ZeniteSolar/MIC19/hardware/IMG/3DDOWN.png

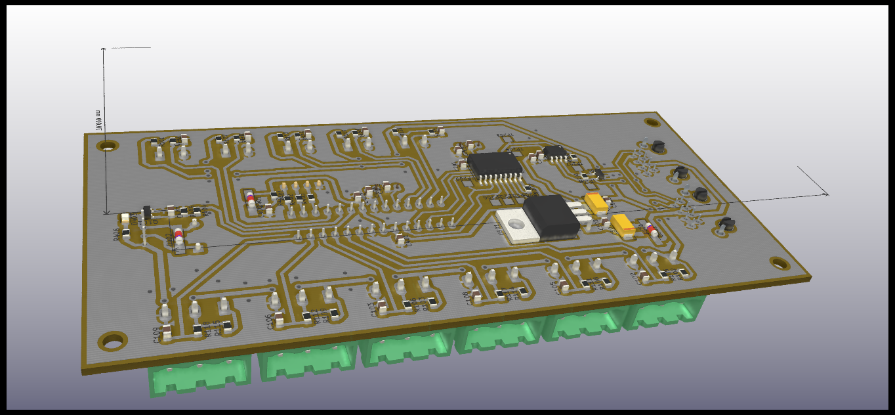
hardware/IMG/3DDOWN.png
