ZeniteSolar/MIC19/hardware/IMG/3DUP.png

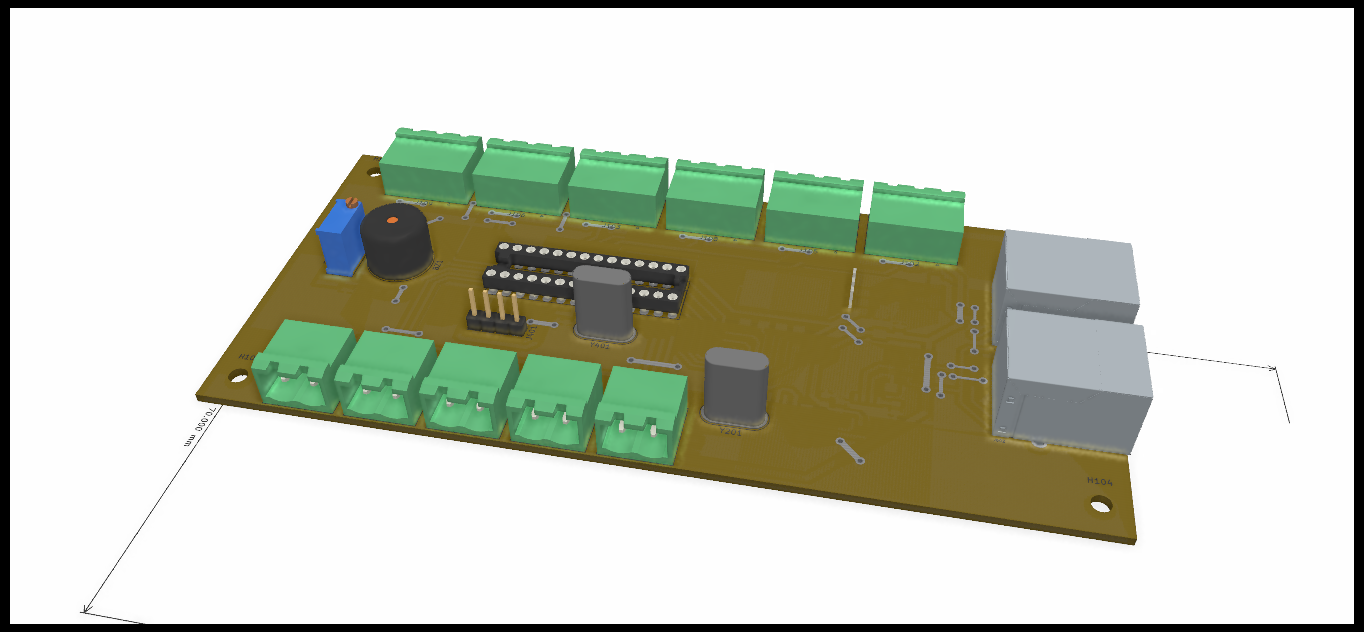
hardware/IMG/3DUP.png
