ZeniteSolar/MIC19/hardware/IMG/layout.png

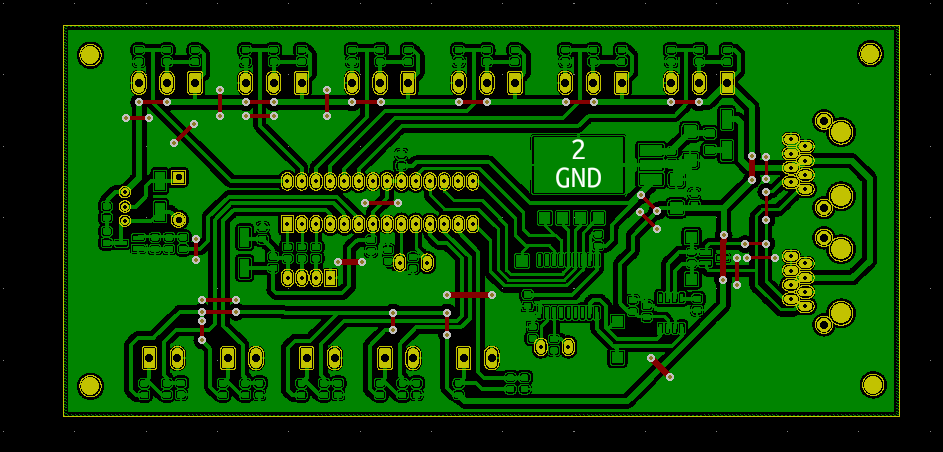
hardware/IMG/layout.png
