ZeniteSolar/MIC19/hardware/rj45.step

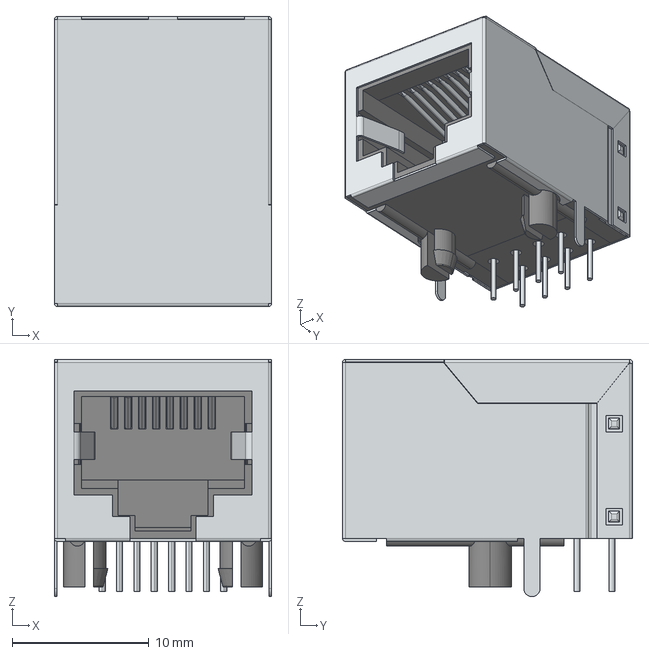
[picture p4: CAD file, 2019-04-30]
hardware/rj45.step
15.9 x 21.2 x 17.3 mm
