ZeniteSolar/MIC19/hardware/PDF/MIC19.pdf

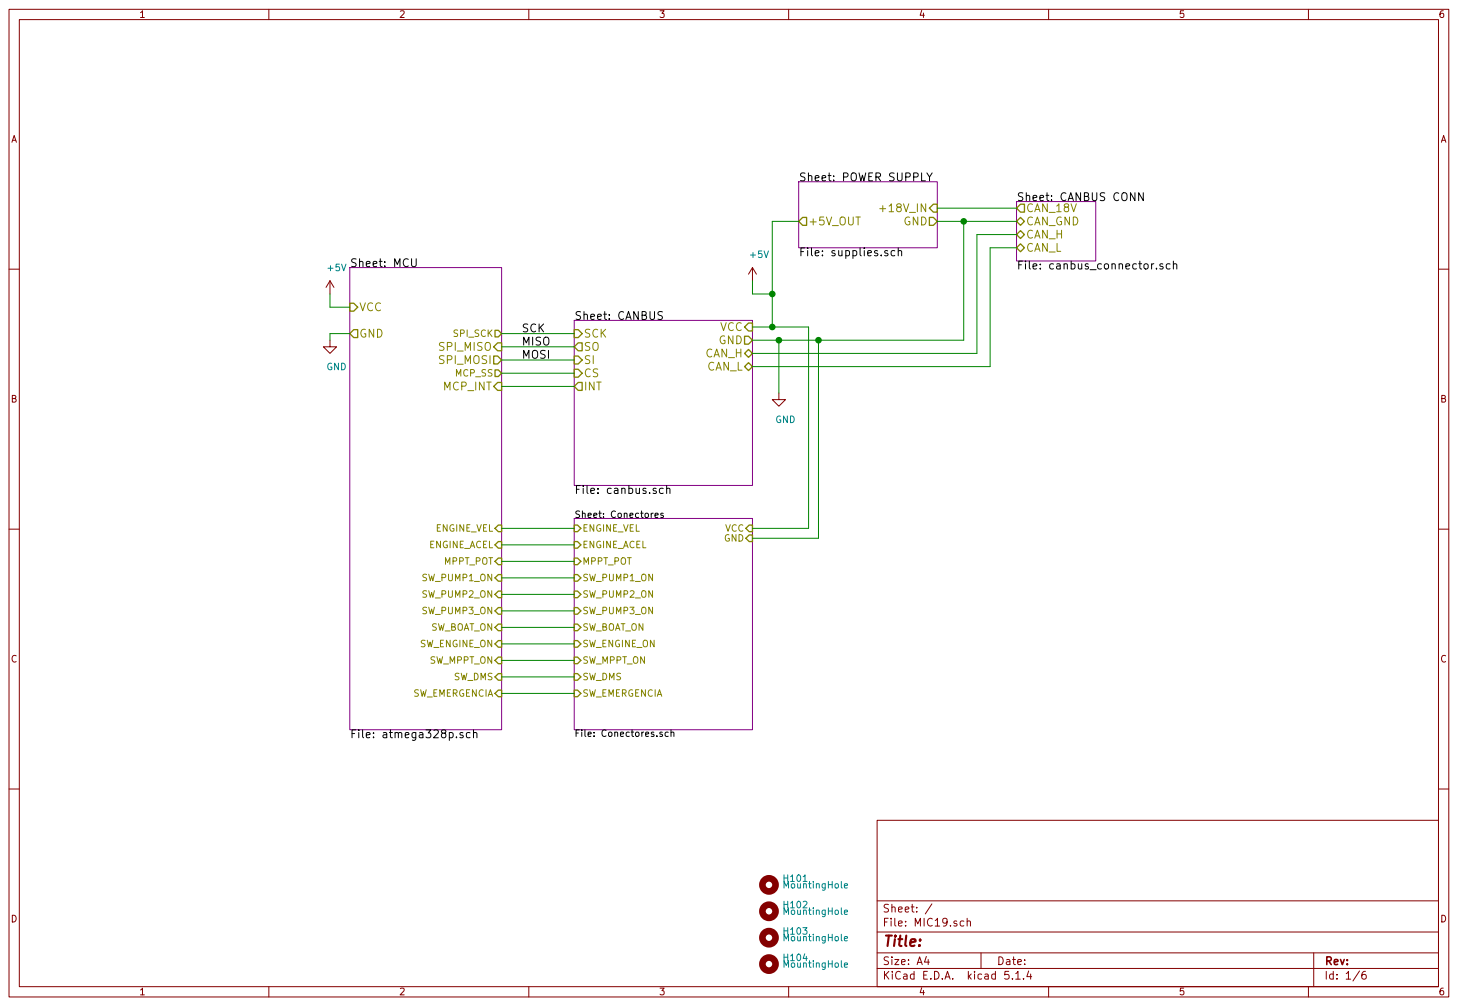
[picture p5: page 1]

Sheet: POWER SUPPLY
+5V GND
SW_EMERGENCIA Sheet: CANBUS
SCK
File: canbus.sch SI

MISO
MOSI

Id: 1/6 Title: File: MIC19.sch Sheet: /

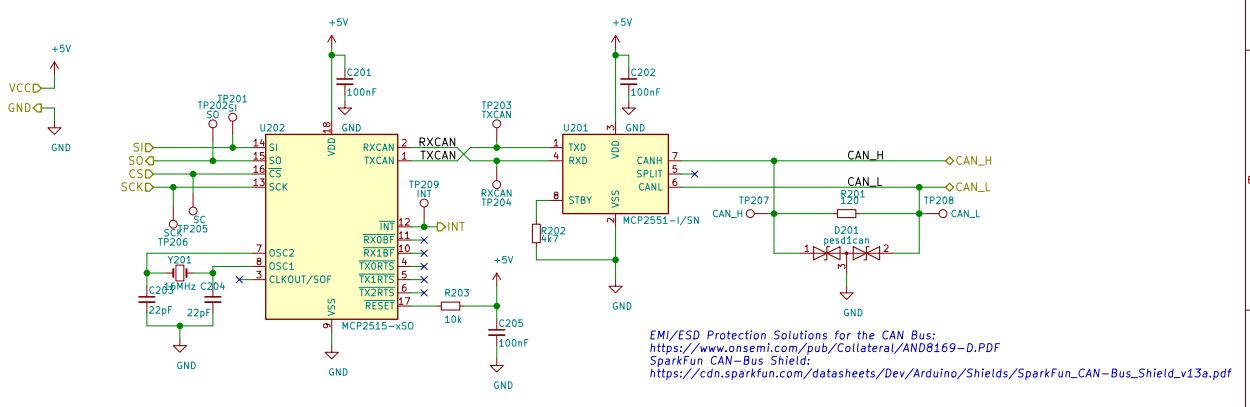
[picture p6: page 2]

3 RXD 4 SPLIT 5 CANL 6 CANH 7 STBY 8 U201 MCP2551-I/SN

EMI/ESD Protection Solutions for the CAN Bus:
https://www.onsemi.com/pub/Collateral/AND8169-D.PDF
SparkFun CAN-Bus Shield:
https://cdn.sparkfun.com/datasheets/Dev/Arduino/Shields/SparkFun_CAN-Bus_Shield_v13a.pdf

Id: 2/6 Title: File: canbus.sch Sheet: /CANBUS/

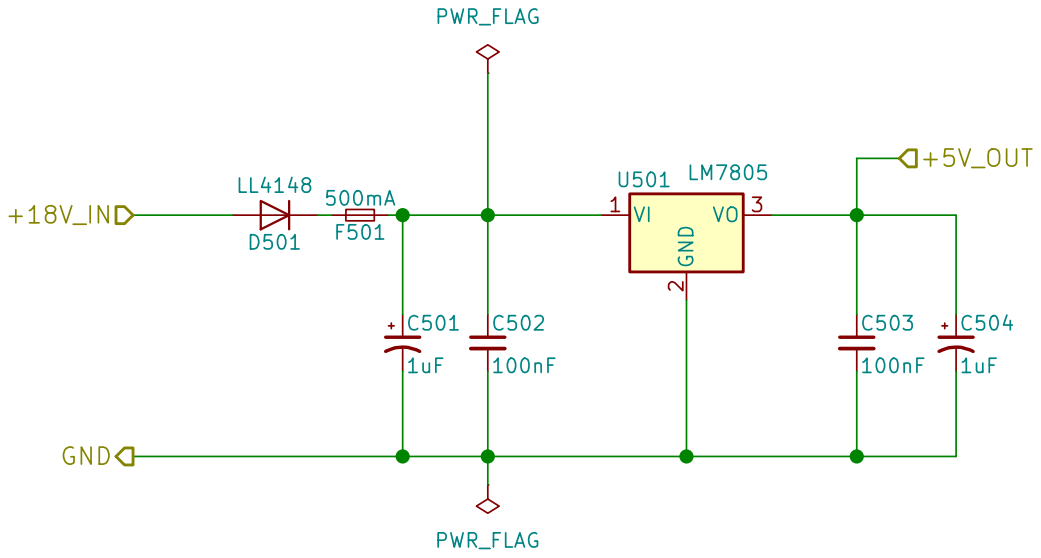
[picture p7: page 3]

File: supplies.sch Sheet: /POWER SUPPLY/
Id: 3/6 Title:

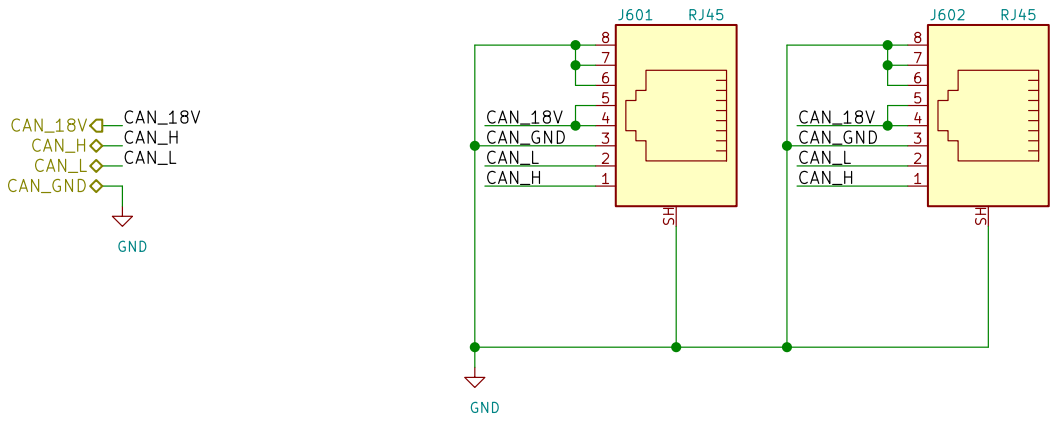
[picture p8: page 4]

File: canbus_connector.sch Sheet: /CANBUS CONN/ GND

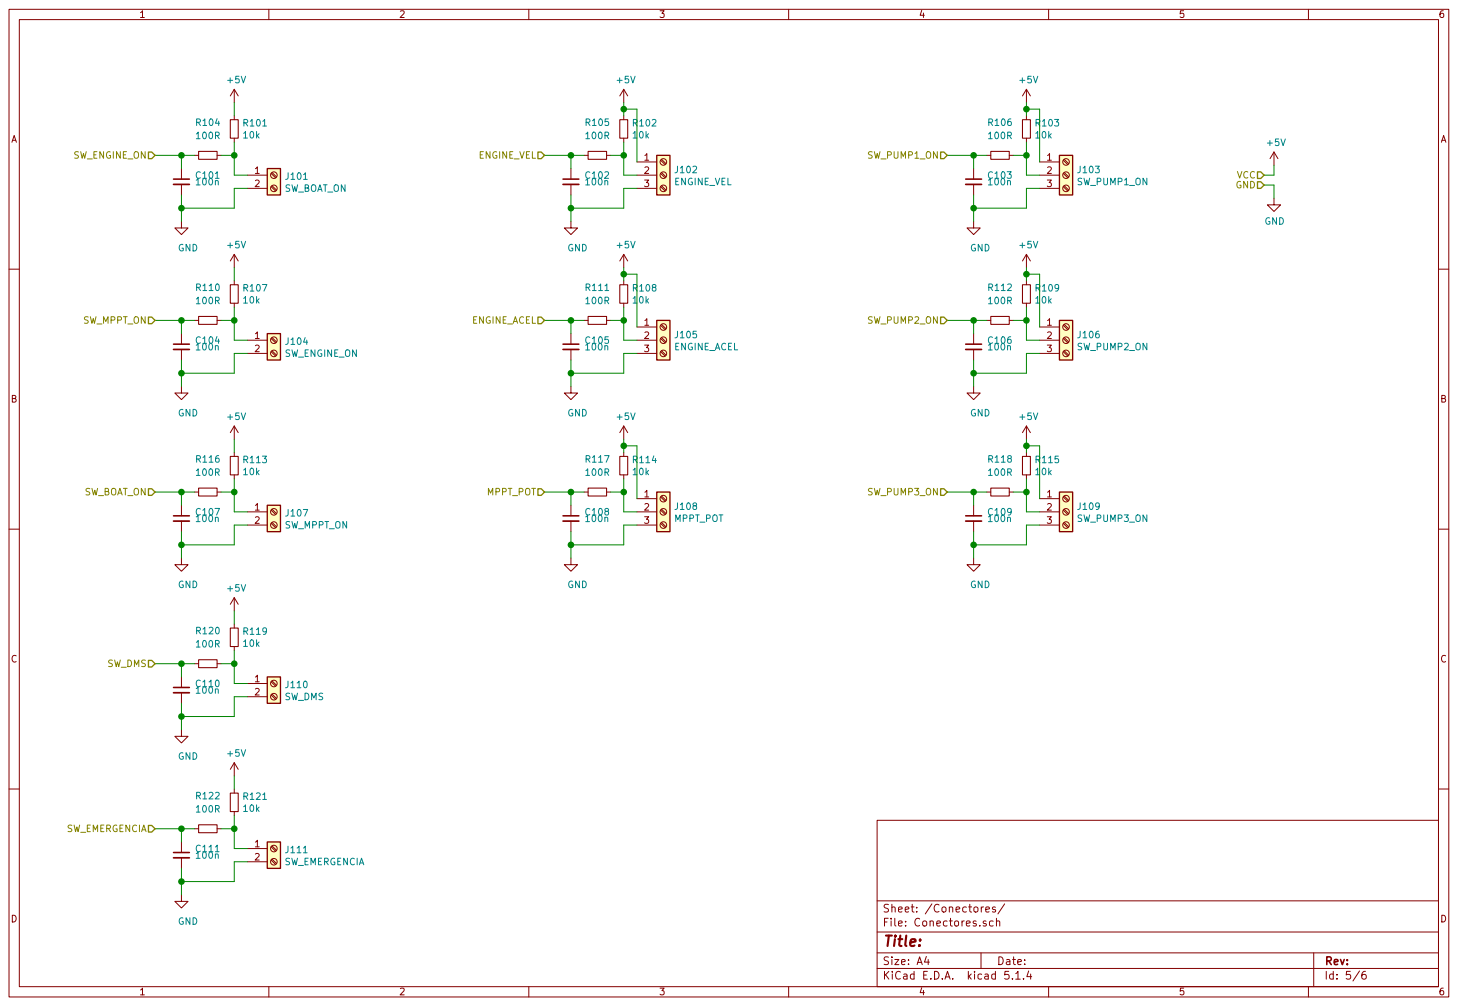
[picture p9: page 5]

Id: 5/6 Title: File: Conectores.sch Sheet: /Conectores/ R116

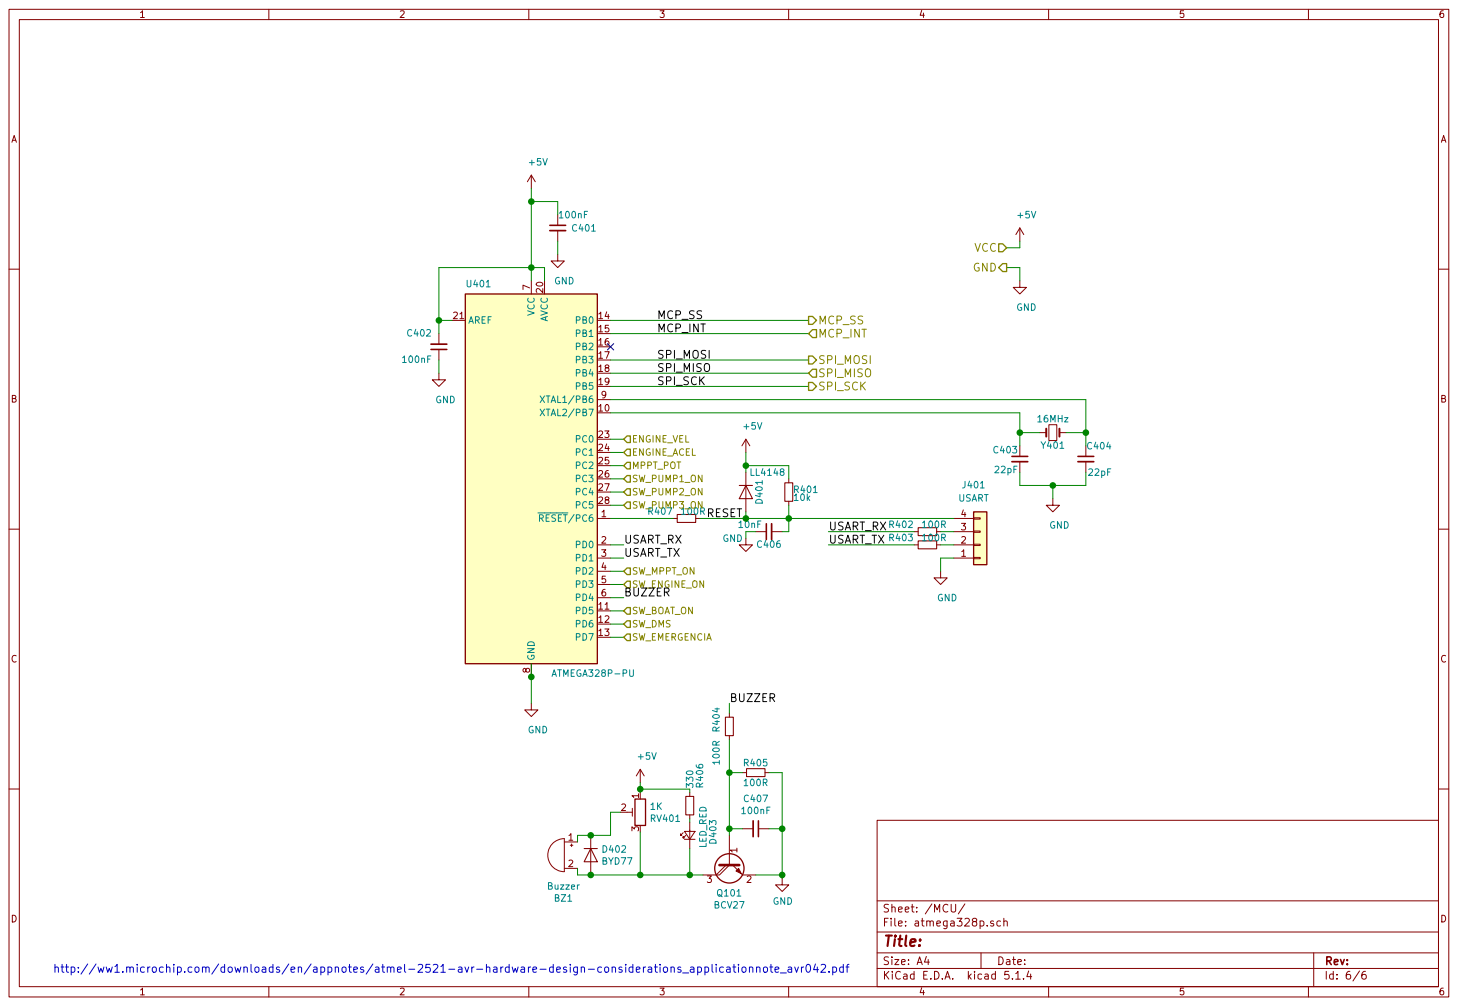
[picture p10: page 6]

File: atmega328p.sch Sheet: /MCU/ R404 100R

http://ww1.microchip.com/downloads/en/appnotes/atmel-2521-avr-hardware-design-considerations_applicationnote_avr042.pdf
