ZeniteSolar/MIC19/hardware/GERBERS/MIC19-B_Cu.pdf

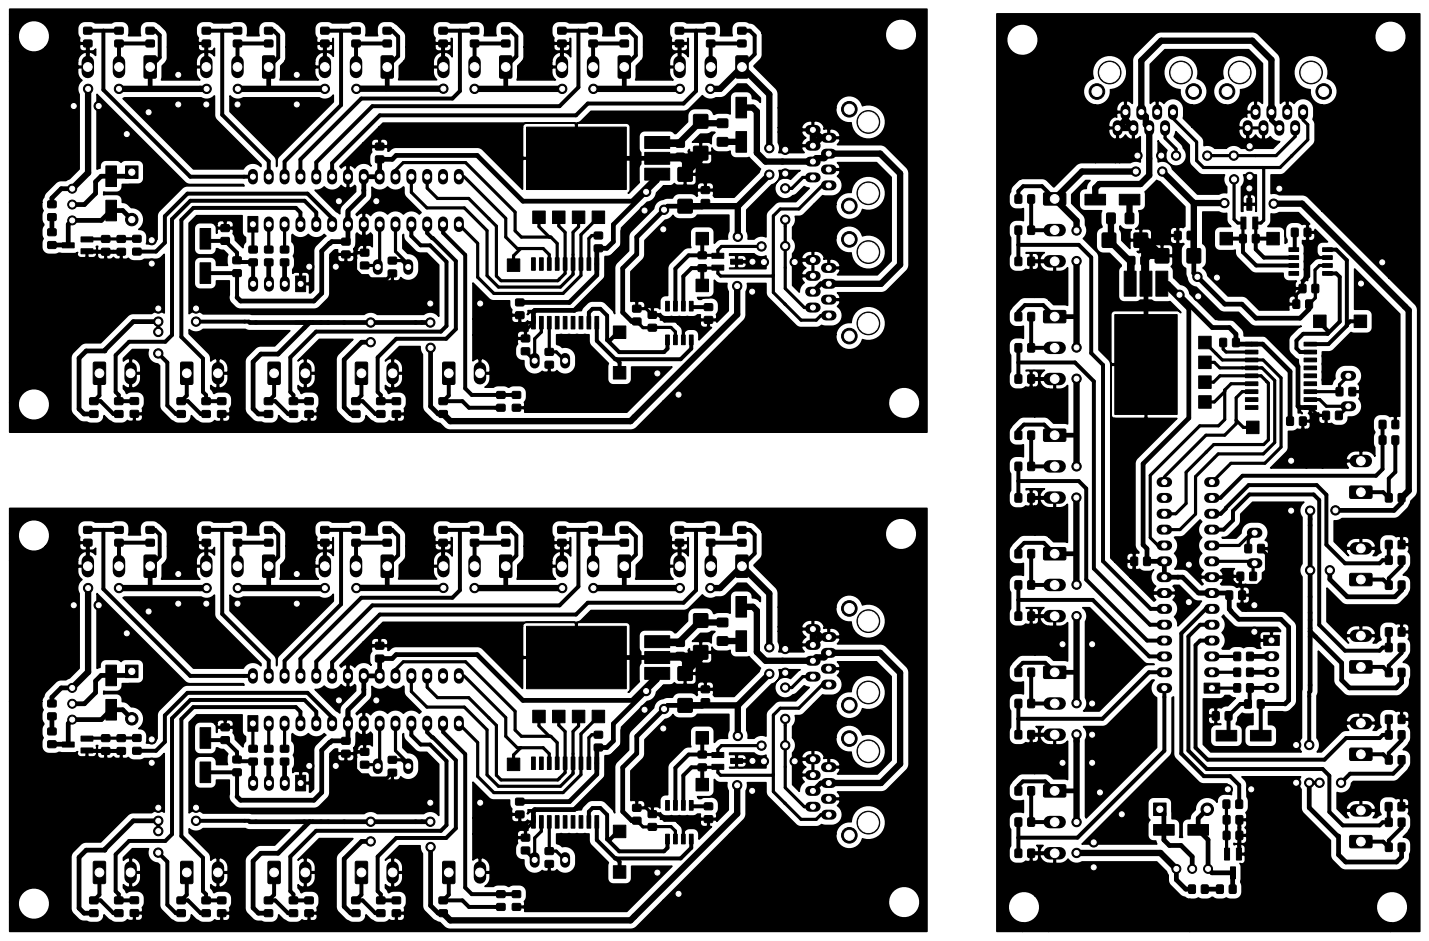
[picture p11: page 1]
