ZeniteSolar/MIC19/hardware/Conectores.sch

## KiCad design hardware/Conectores.sch (2019-08-21)

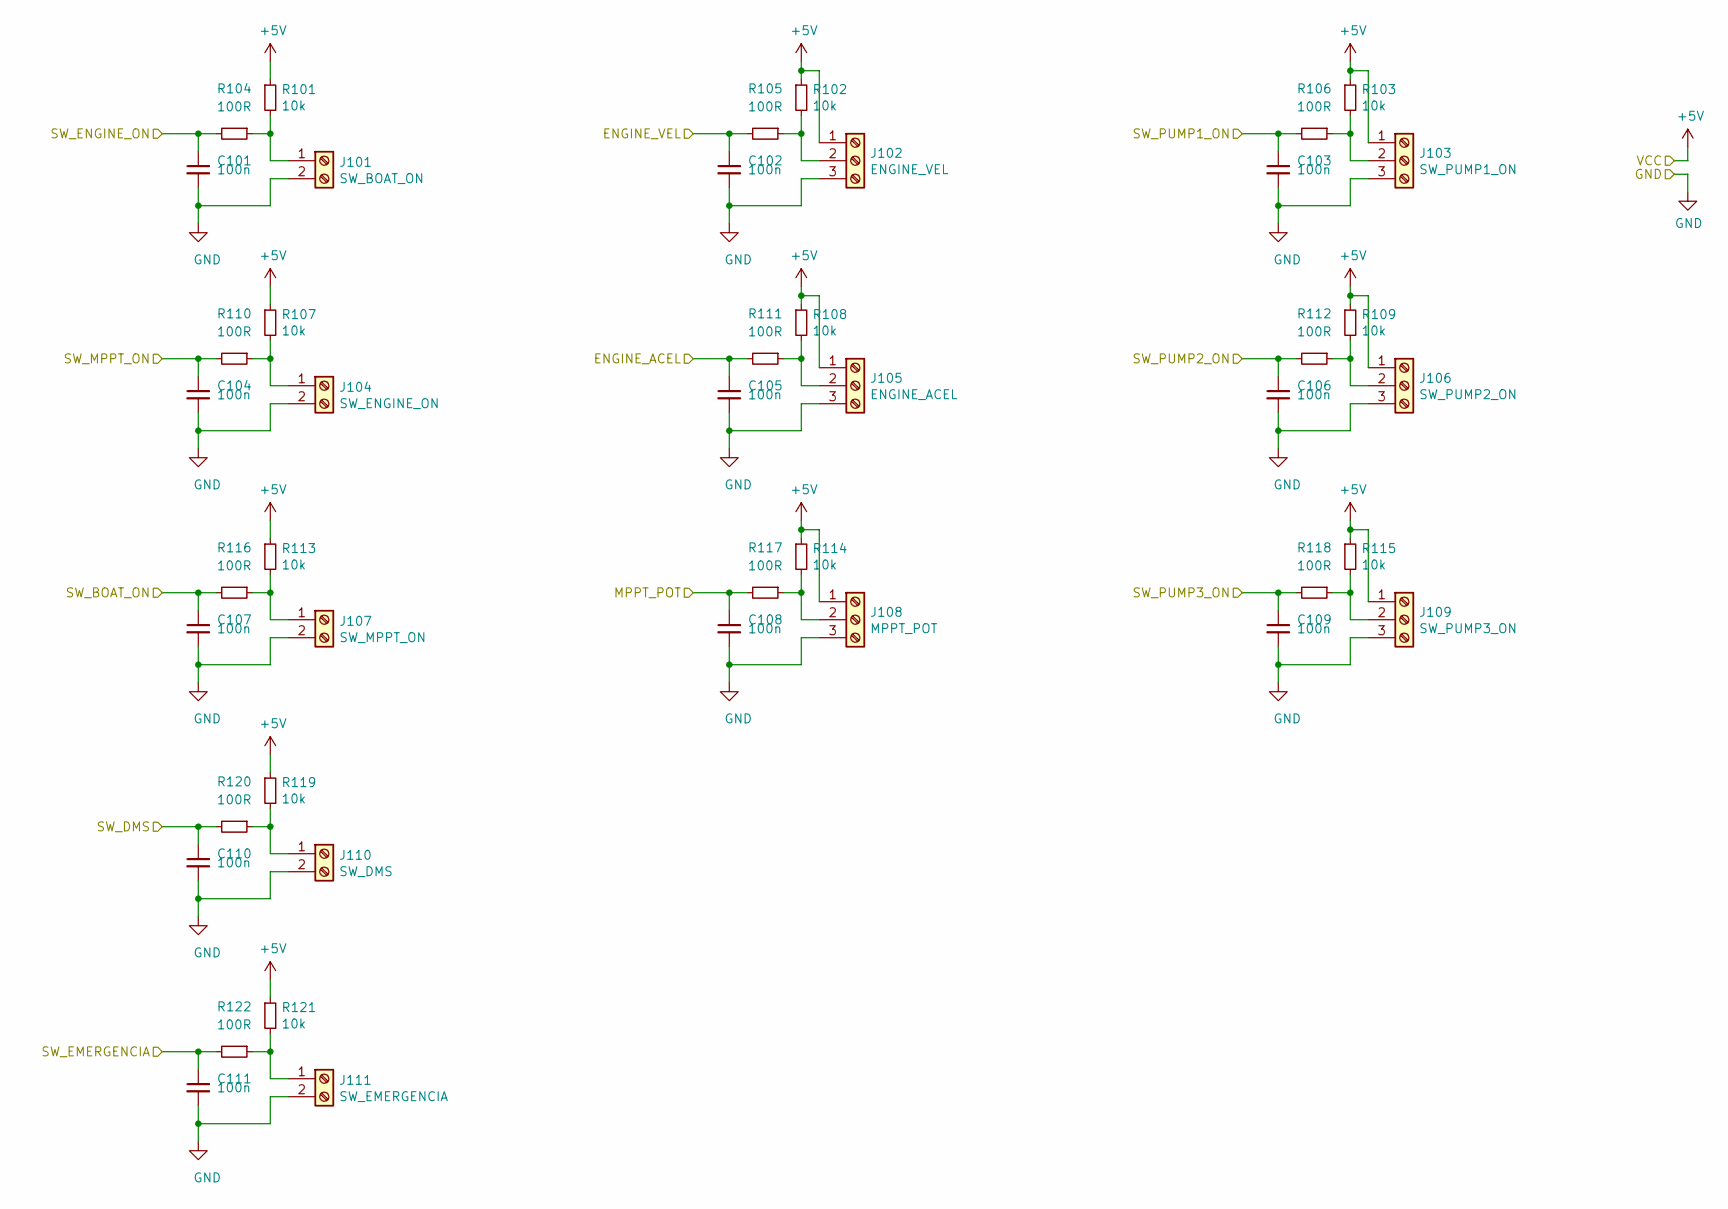
[picture p12: schematic Conectores.sch]

Parts:
C101, C102, C103, C104, C105, C106, C107, C108, C109, C110, C111: 100n; C_0805_2012Metric_Pad1.15x1.40mm_HandSolder
J101: SW_BOAT_ON; PhoenixContact_MSTBA_2,5_2-G_1x02_P5.00mm_Horizontal
J102: ENGINE_VEL; PhoenixContact_MSTBA_2,5_3-G_1x03_P5.00mm_Horizontal
J103: SW_PUMP1_ON; PhoenixContact_MSTBA_2,5_3-G_1x03_P5.00mm_Horizontal
J104: SW_ENGINE_ON; PhoenixContact_MSTBA_2,5_2-G_1x02_P5.00mm_Horizontal
J105: ENGINE_ACEL; PhoenixContact_MSTBA_2,5_3-G_1x03_P5.00mm_Horizontal
J106: SW_PUMP2_ON; PhoenixContact_MSTBA_2,5_3-G_1x03_P5.00mm_Horizontal
J107: SW_MPPT_ON; PhoenixContact_MSTBA_2,5_2-G_1x02_P5.00mm_Horizontal
J108: MPPT_POT; PhoenixContact_MSTBA_2,5_3-G_1x03_P5.00mm_Horizontal
J109: SW_PUMP3_ON; PhoenixContact_MSTBA_2,5_3-G_1x03_P5.00mm_Horizontal
J110: SW_DMS; PhoenixContact_MSTBA_2,5_2-G_1x02_P5.00mm_Horizontal
J111: SW_EMERGENCIA; PhoenixContact_MSTBA_2,5_2-G_1x02_P5.00mm_Horizontal
R101, R102, R103, R107, R108, R109, R113, R114, R115, R119, R121: 10k; R_0805_2012Metric_Pad1.15x1.40mm_HandSolder
R104, R105, R106, R110, R111, R112, R116, R117, R118, R120, R122: 100R; R_0805_2012Metric_Pad1.15x1.40mm_HandSolder

Connections:
+5V: J102.1, J103.1, J105.1, J106.1, J108.1, J109.1, R101.1, R102.1, R103.1, R107.1, R108.1, R109.1, R113.1, R114.1, R115.1, R119.1, R121.1
ENGINE_ACEL: C105.1, R111.2
ENGINE_VEL: C102.1, R105.2
GND: C101.2, C102.2, C103.2, C104.2, C105.2, C106.2, C107.2, C108.2, C109.2, C110.2, C111.2, J101.2, J102.3, J103.3, J104.2, J105.3, J106.3, J107.2, J108.3, J109.3, J110.2, J111.2
MPPT_POT: C108.1, R117.2
unnamed: J101.1, R101.2, R104.1
unnamed: J102.2, R102.2, R105.1
unnamed: J103.2, R103.2, R106.1
unnamed: J104.1, R107.2, R110.1
unnamed: J105.2, R108.2, R111.1
unnamed: J106.2, R109.2, R112.1
unnamed: J107.1, R113.2, R116.1
unnamed: J108.2, R114.2, R117.1
unnamed: J109.2, R115.2, R118.1
unnamed: J110.1, R119.2, R120.1
unnamed: J111.1, R121.2, R122.1
SW_BOAT_ON: C107.1, R116.2
SW_DMS: C110.1, R120.2
SW_EMERGENCIA: C111.1, R122.2
SW_ENGINE_ON: C101.1, R104.2
SW_MPPT_ON: C104.1, R110.2
SW_PUMP1_ON: C103.1, R106.2
SW_PUMP2_ON: C106.1, R112.2
SW_PUMP3_ON: C109.1, R118.2
