ZeniteSolar/MIC19/hardware/MIC19.sch

## KiCad design hardware/MIC19.sch (2019-08-21)

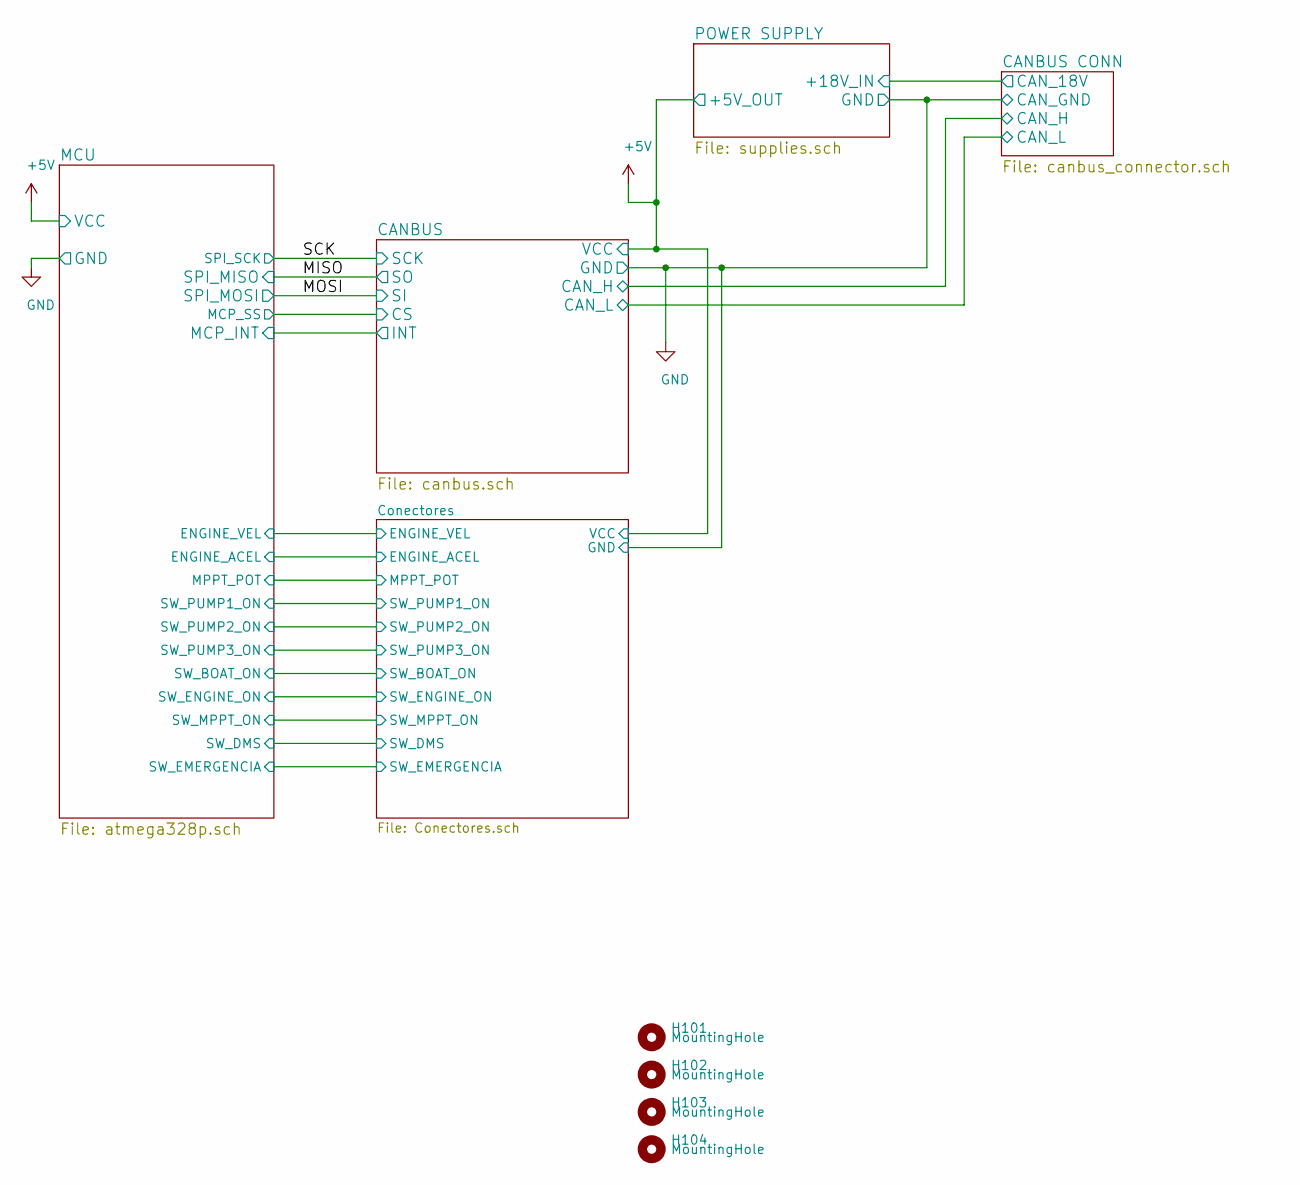
[picture p13: schematic MIC19.sch]

Parts:
H101, H102, H103, H104: MountingHole; MountingHole_3.2mm_M3
