ZeniteSolar/MIC19/hardware/analog.sch

## KiCad design hardware/analog.sch (2019-04-30)

Schematic: analog.sch

Parts:
C301, C302, C303, C304: 100n; C_0805_2012Metric_Pad1.15x1.40mm_HandSolder
D301: 4V7; D_MiniMELF_Handsoldering
R301, R303, R304, R308, R309: 10k; R_0805_2012Metric_Pad1.15x1.40mm_HandSolder
R302: 100k; R_0805_2012Metric_Pad1.15x1.40mm_HandSolder
R305, R306, R307: 1k; R_0805_2012Metric_Pad1.15x1.40mm_HandSolder
TP301: op_a_in-; TestPoint_Pad_2.0x2.0mm
TP302: op_a_out; TestPoint_Pad_2.0x2.0mm
TP303: in-; TestPoint_Pad_2.0x2.0mm
TP304: op_b_out; TestPoint_Pad_2.0x2.0mm
TP305: op_b_in+; TestPoint_Pad_2.0x2.0mm
TP306: in+; TestPoint_Pad_2.0x2.0mm
TP307: op_a_in+; TestPoint_Pad_2.0x2.0mm
U301: LM324; SOIC-14_3.9x8.7mm_P1.27mm

Notes on the sheet:
https://www.edn.com/electronics-blogs/bakers-best/4418766/Closer-to-real-world-analog-filters
0R for current
30R for current
