ZeniteSolar/MIC19/hardware/atmega328p.sch

## KiCad design hardware/atmega328p.sch (2019-08-21)

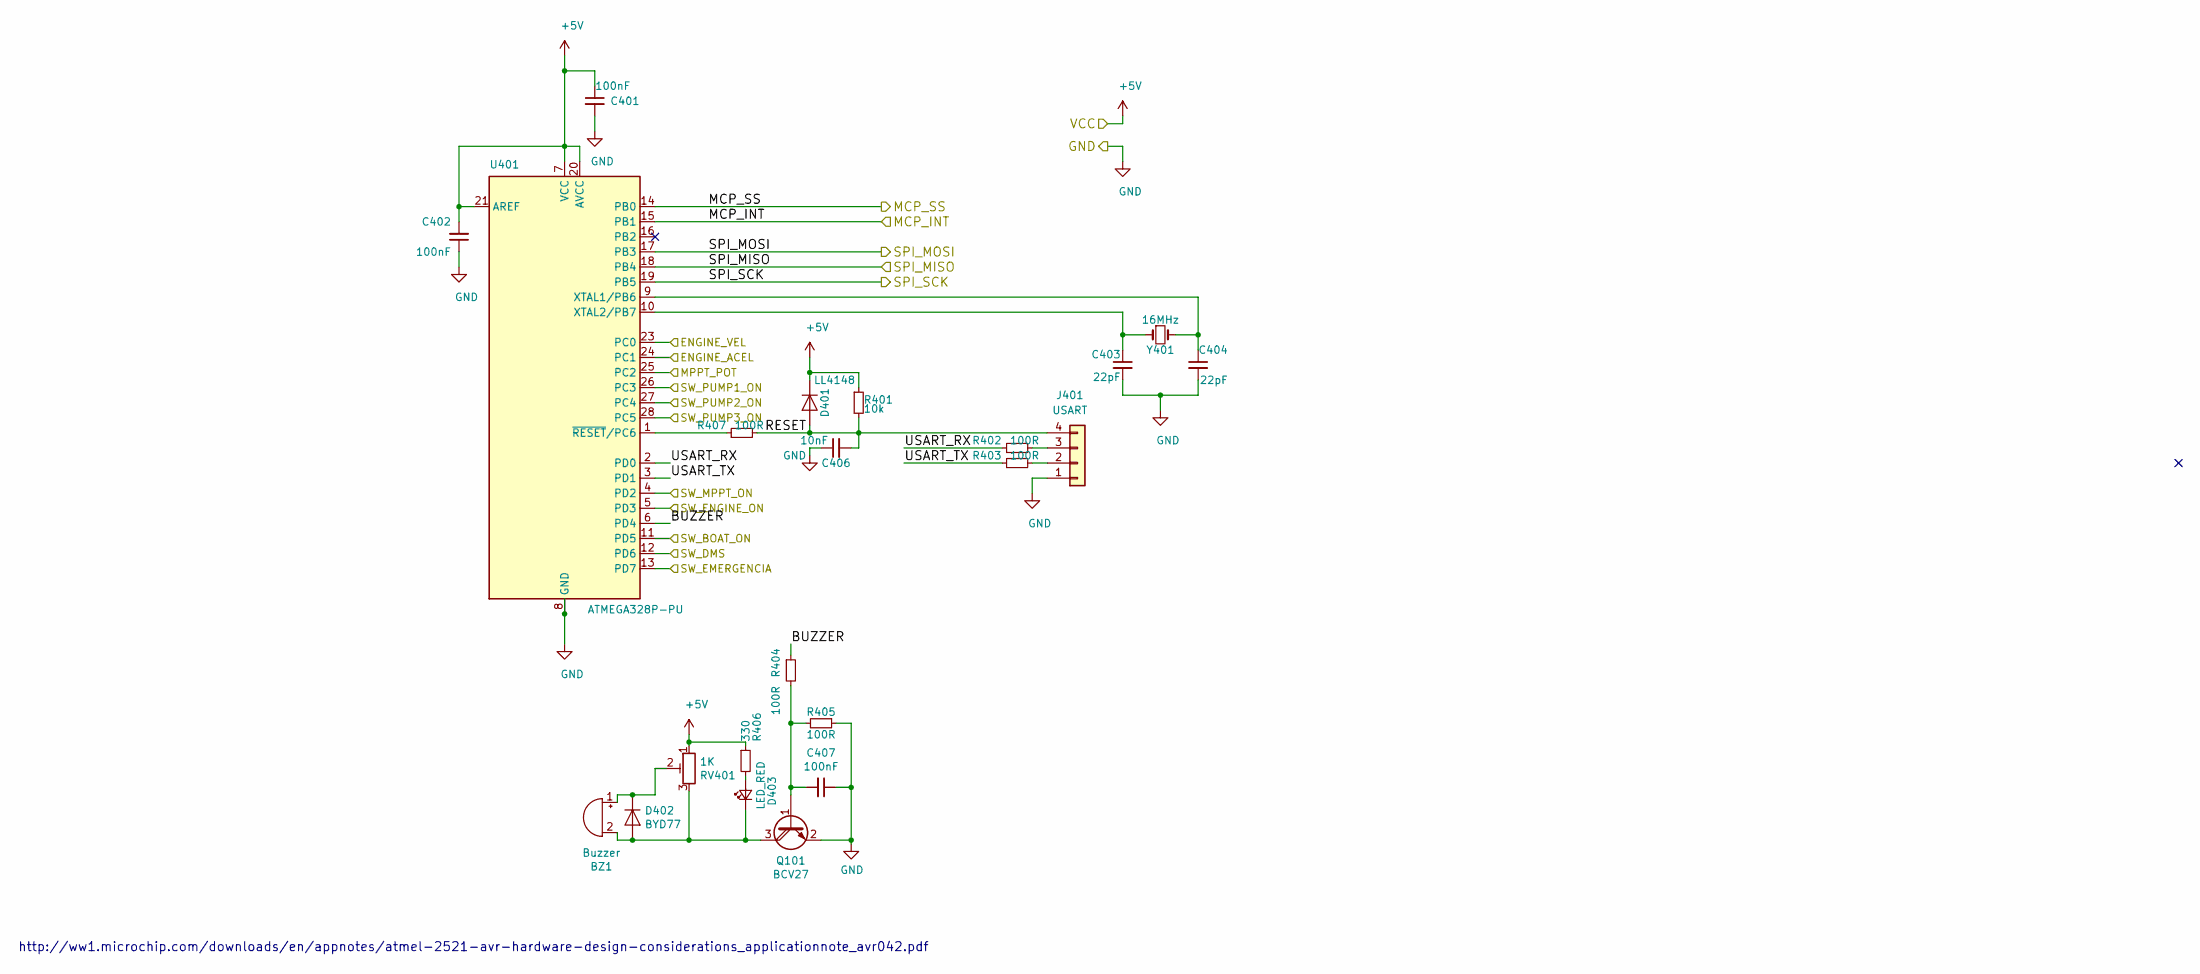
[picture p14: schematic atmega328p.sch]

Parts:
BZ1: Buzzer; Buzzer_12x9.5RM7.6
C401, C402, C407: 100nF; C_0805_2012Metric_Pad1.15x1.40mm_HandSolder
C403, C404: 22pF; C_0805_2012Metric_Pad1.15x1.40mm_HandSolder
C406: 10nF; C_0805_2012Metric_Pad1.15x1.40mm_HandSolder
D401: LL4148; D_MiniMELF_Handsoldering
D402: BYD77; D_MiniMELF_Handsoldering
D403: LED_RED; LED_0805_2012Metric_Pad1.15x1.40mm_HandSolder
J401: USART; PinHeader_1x04_P2.54mm_Vertical
Q101: BCV27; SOT-23_Handsoldering
R401: 10k; R_0805_2012Metric_Pad1.15x1.40mm_HandSolder
R402, R403, R404, R405, R407: 100R; R_0805_2012Metric_Pad1.15x1.40mm_HandSolder
R406: 330; R_0805_2012Metric_Pad1.15x1.40mm_HandSolder
RV401: 1K; Potentiometer_Bourns_3296W_Vertical
U401: ATMEGA328P-PU; DIP-28_W7.62mm_Socket
Y401: 16MHz; Crystal_HC49-U_Vertical

Connections:
+5V: C401.1, C402.2, D401.1 (K), R401.1, R406.1, RV401.1, U401.7 (VCC), U401.20 (AVCC), U401.21 (AREF)
BUZZER: R404.1, U401.6 (PD4)
ENGINE_ACEL: U401.24 (PC1)
ENGINE_VEL: U401.23 (PC0)
GND: C401.2, C402.1, C403.2, C404.2, C406.1, C407.1, J401.1, Q101.2 (E), R405.1, U401.8 (GND), U401.22 (GND)
MCP_INT: U401.15 (PB1)
MCP_SS: U401.14 (PB0)
MPPT_POT: U401.25 (PC2)
unnamed: BZ1.1 (-), D402.1 (K), RV401.2
unnamed: BZ1.2 (+), D402.2 (A), D403.1 (K), Q101.3 (C), RV401.3
unnamed: C403.1, U401.10 (XTAL2/PB7), Y401.1
unnamed: C404.1, U401.9 (XTAL1/PB6), Y401.2
unnamed: C407.2, Q101.1 (B), R404.2, R405.2
unnamed: D403.2 (A), R406.2
unnamed: J401.2, R403.2
unnamed: J401.3, R402.2
unnamed: R407.1, U401.1 (~RESET~/PC6)
RESET: C406.2, D401.2 (A), J401.4, R401.2, R407.2
SPI_MISO: U401.18 (PB4)
SPI_MOSI: U401.17 (PB3)
SPI_SCK: U401.19 (PB5)
SW_BOAT_ON: U401.11 (PD5)
SW_DMS: U401.12 (PD6)
SW_EMERGENCIA: U401.13 (PD7)
SW_ENGINE_ON: U401.5 (PD3)
SW_MPPT_ON: U401.4 (PD2)
SW_PUMP1_ON: U401.26 (PC3)
SW_PUMP2_ON: U401.27 (PC4)
SW_PUMP3_ON: U401.28 (PC5)
USART_RX: R402.1, U401.2 (PD0)
USART_TX: R403.1, U401.3 (PD1)

Notes on the sheet:
http://ww1.microchip.com/downloads/en/appnotes/atmel-2521-avr-hardware-design-considerations_applicationnote_avr042.pdf
