ZeniteSolar/MIC19/hardware/canbus.sch

## KiCad design hardware/canbus.sch (2019-08-21)

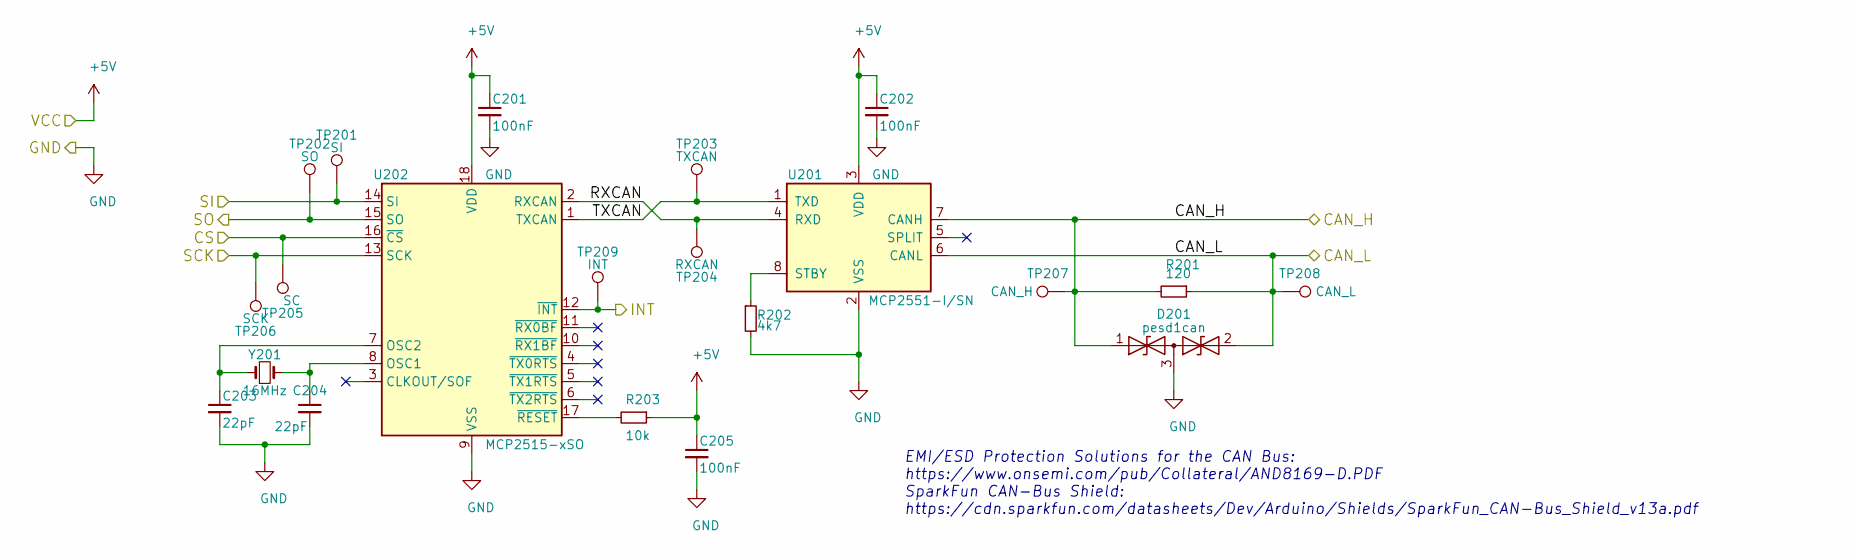
[picture p15: schematic canbus.sch]

Parts:
C201, C202, C205: 100nF; C_0805_2012Metric_Pad1.15x1.40mm_HandSolder
C203, C204: 22pF; C_0805_2012Metric_Pad1.15x1.40mm_HandSolder
D201: pesd1can; SOT-23_Handsoldering
R201: 120; R_0805_2012Metric_Pad1.15x1.40mm_HandSolder
R202: 4k7; R_0805_2012Metric_Pad1.15x1.40mm_HandSolder
R203: 10k; R_0805_2012Metric_Pad1.15x1.40mm_HandSolder
TP201: SI; TestPoint_Pad_2.0x2.0mm
TP202: SO; TestPoint_Pad_2.0x2.0mm
TP203: TXCAN; TestPoint_Pad_2.0x2.0mm
TP204: RXCAN; TestPoint_Pad_2.0x2.0mm
TP205: SC; TestPoint_Pad_2.0x2.0mm
TP206: SCK; TestPoint_Pad_2.0x2.0mm
TP207: CAN_H; TestPoint_Pad_2.0x2.0mm
TP208: CAN_L; TestPoint_Pad_2.0x2.0mm
TP209: INT; TestPoint_Pad_2.0x2.0mm
U201: MCP2551-I/SN; SOIC-8_3.9x4.9mm_P1.27mm
U202: MCP2515-xSO; SOIC-18W_7.5x11.6mm_P1.27mm
Y201: 16MHz; Crystal_HC49-U_Vertical

Connections:
+5V: C201.1, C202.1, C205.1, R203.1, U201.3 (VDD), U202.18 (VDD)
CAN_H: D201.1 (A1), R201.2, TP207.1, U201.7 (CANH)
CAN_L: D201.2 (A2), R201.1, TP208.1, U201.6 (CANL)
CS: TP205.1, U202.16 (~CS)
GND: C201.2, C202.2, C203.2, C204.2, C205.2, D201.3 (common), R202.2, U201.2 (VSS), U202.9 (VSS)
INT: TP209.1, U202.12 (~INT)
unnamed: C203.1, U202.7 (OSC2), Y201.1
unnamed: C204.1, U202.8 (OSC1), Y201.2
unnamed: R202.1, U201.8 (STBY)
unnamed: R203.2, U202.17 (~RESET)
RXCAN: TP204.1, U201.4 (RXD), U202.2 (RXCAN)
SCK: TP206.1, U202.13 (SCK)
SI: TP201.1, U202.14 (SI)
SO: TP202.1, U202.15 (SO)
TXCAN: TP203.1, U201.1 (TXD), U202.1 (TXCAN)

Notes on the sheet:
EMI/ESD Protection Solutions for the CAN Bus: https://www.onsemi.com/pub/Collateral/AND8169-D.PDF SparkFun CAN-Bus Shield: https://cdn.sparkfun.com/datasheets/Dev/Arduino/Shields/SparkFun_CAN-Bus_Shield_v13a.pdf
