ZeniteSolar/MIC19/hardware/canbus_connector.sch

## KiCad design hardware/canbus_connector.sch (2019-08-21)

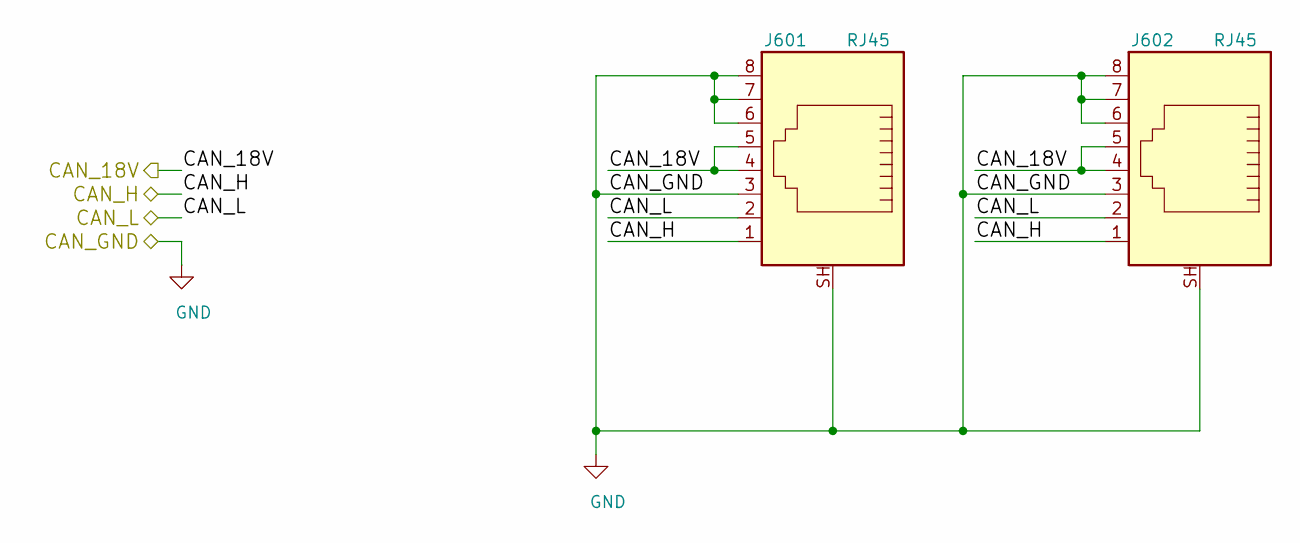
[picture p16: schematic canbus_connector.sch]

Parts:
J601, J602: RJ45; RJ45_YH59_01

Connections:
CAN_18V: J601.4, J601.5, J602.4, J602.5
CAN_H: J601.1, J602.1
CAN_L: J601.2, J602.2
GND: J601.3, J601.6, J601.7, J601.8, J601.SH, J602.3, J602.6, J602.7, J602.8, J602.SH
