ZeniteSolar/MIC19/hardware/supplies.sch

## KiCad design hardware/supplies.sch (2019-08-21)

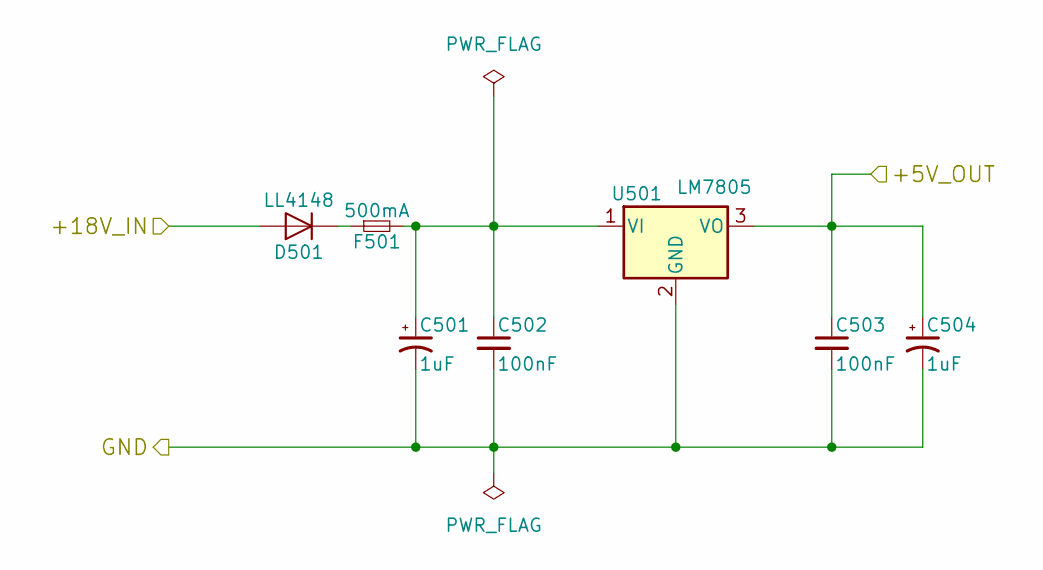
[picture p17: schematic supplies.sch]

Parts:
C501, C504: 1uF; CP_EIA-6032-20_AVX-F_Pad2.25x2.35mm_HandSolder
C502, C503: 100nF; C_0805_2012Metric_Pad1.15x1.40mm_HandSolder
D501: LL4148; D_MiniMELF_Handsoldering
F501: 500mA; Fuse_1206_3216Metric_Pad1.42x1.75mm_HandSolder
U501: LM7805; TO-220-3_Horizontal_TabDown_SMD

Connections:
+5V_OUT: C503.1, C504.1, U501.3 (VO)
+18V_IN: D501.2 (A)
GND: C501.2, C502.2, C503.2, C504.2, U501.2 (GND)
unnamed: C501.1, C502.1, F501.2, U501.1 (VI)
unnamed: D501.1 (K), F501.1
