ZeniteSolar/MIC19/(commit log)

2019-04-30 Hardware inicial
    [MIC19.kicad_pcb, MIC19.sch, analog.sch, atmega328p.sch, canbus.sch, canbus_connector.sch, rj45.step, supplies.sch]
2019-06-10 Atualização do MIC19
    [Conectores.sch, MIC19.kicad_pcb, MIC19.sch, atmega328p.sch, canbus.sch, canbus_connector.sch, supplies.sch]
2019-07-31 Formato da placa modificado
    [Conectores.sch, MIC19.kicad_pcb, MIC19.sch, atmega328p.sch, canbus.sch, canbus_connector.sch, supplies.sch]
2019-08-01 Modificaçoes nos resistores pull-up e modificaçoes no layout
    [Conectores.sch, MIC19.kicad_pcb, atmega328p.sch]
2019-08-01 adc average
2019-08-02 mcs and pumps
2019-08-02 Pump error can_app_send_pump have errors
    [can_app.c]
2019-08-05 MIC can talk!!!
    Created Buzzer function
    [can_app.c, can_app.h, can_filters.h, conf.h, machine.c, machine.h]
2019-08-06 06/08/2019
    Adicionei um jumper no buzzer para que ele possa ser desativado durante os testes;
    separei os componentes que irão para cara conector KRE para depois serem montados
    [Conectores.sch, MIC19.sch, atmega328p.sch, canbus.sch, canbus_connector.sch]
2019-08-06 Modelo final
    Terminado os conectores e a topologia
    [Conectores.sch, MIC19.kicad_pcb, MIC19.sch, atmega328p.sch, canbus.sch, canbus_connector.sch]
2019-08-06 Buzzer estava invertido, alimentações melhoradas. A alimentação do atmega foi isolada em relação aos switches.
    [Conectores.sch, MIC19.kicad_pcb, MIC19.sch, atmega328p.sch, canbus.sch, canbus_connector.sch]
2019-08-07 Roteamento de alimentação alterado e placa compactada.
    [MIC19.kicad_pcb]
2019-08-08 Final
    Terminado detalhes que eram necessário para finalizar a placa, como trilhas de Vcc e Gnd remodeladas para melhor fluxo da corrente
    [MIC19.kicad_pcb]
2019-08-21 Conferido e Finalizado
    [Conectores.sch, MIC19.kicad_pcb, MIC19.sch, atmega328p.sch, canbus.sch, canbus_connector.sch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]
2019-09-11 Emergency switch
2020-01-20 renamed to lowercase
    [Conectores.sch, MIC19.kicad_pcb, MIC19.sch, analog.sch, atmega328p.sch, canbus.sch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]
2020-01-28 printing can messages
2022-02-26 Use extern modifier to fix duplicated variables being defined on newer GCC
    [adc.c, adc.h, can_app.c, can_app.h, machine.c, machine.h]
2022-02-26 Use the pump3 switch to do the Reverse, update can MOTOR message.
    [can_app.c, conf.h, machine.c, machine.h, main.c]
2022-03-21 Read steering wheel potentiometer and send it in the MDE message.
    Steering Wheel Potentiometer is using the input was used for MPPT Max Power
2022-03-21 Fix can MDE ids, length, and div clock for MDE and PUMPS messages.
    [can_app.c]
2022-07-23 Send steering pot value uint16
2022-07-25 send mde now averga MDE pot, instead of Motor
2022-08-16 ADC 10 bit, doesnt check for MCS
2022-10-24 ADC 8 bits
2023-04-29 Fix ADC and machine frequency computation
    [adc.h, conf.h, machine.h]
2023-04-29 Add interactive bom
2023-06-01 rewrite adc value and frequency computation
2023-06-01 fix adc 10bit messages
    [can_app.c]
2023-06-01 use 10bit adc
2023-06-01 instead of compute one average in adc file and another in machine file, only use the adc average in machine file
2023-06-01 initialize emergency switch and init machine
2025-06-04 better print infos
2025-06-04 frequency safeguard for compiling code, new adc functions
2025-06-05 adc now using CBUF
2025-06-05 Using new adc, and new macros in header file
2025-06-05 new adc functions and print info macros
2025-06-05 new adc functions, led frequencies and print macros
2025-06-05 new kicad versions are very annoying
2025-06-05 working adc considering hardware issues
    [adc.c, adc.h]
2025-06-05 keep software safety on BMS+Emergency for testing
2025-06-07 basic print infos: pots and 3 main switches
2025-06-08 Flip logic for main switches: boat, motor, reverse
    [machine.c]
2025-06-14 Warning if LED_ON buzzer will be very annoying
    [conf.h]
2025-06-14 change print infos time - should be clear, timer looks weird
2025-10-29 Mudança de can_ids pro can_ids do MCV25
2025-10-29 Adição das funções de extractor do MCV25, modificação da can_app_msg_extractors_switch para leitura do MCV25, modificação do can_app_send_motor e criação de variáveis da zenira
2025-10-29 Adição dos cabeçalhos de funções de extractor do MCV25
2025-10-29 Mudança dos filters pare receber mensagens can do MCV25
2025-10-29 Verboso ON para debug
2025-12-19 Zenira last update -> MDE and PWM thresholds adjusts and pilot priority changes
